sparkfun/SparkFun_Qwiic_BMA456_Accelerometer/docs/docs/Resources.md

For more information about the SparkFun Triple Axis Accelerometer Breakout - BMA456 (Qwiic) take a look at the following resources:

* [Schematic](/ref/Qwiic_BMA456.pdf)
* [KiCad Files](/ref/Qwiic_BMA456.zip)
* [Board Dimensions]()
* [Datasheet](/ref/bma456.pdf) (BMA456)
* [SparkFun BMA456 Arduino Library](https://github.com/sparkfun/SparkFun_BMA456_Arduino_Library)
* [GitHub Repository](https://github.com/sparkfun/SparkFun_Qwiic_BMA456_Accelerometer)
