sparkfun/SparkFun_Qwiic_BMA456_Accelerometer/Hardware/Qwiic_BMA456.kicad_pcb

## KiCad design Hardware/Qwiic_BMA456.kicad_pcb (2026-09-10)

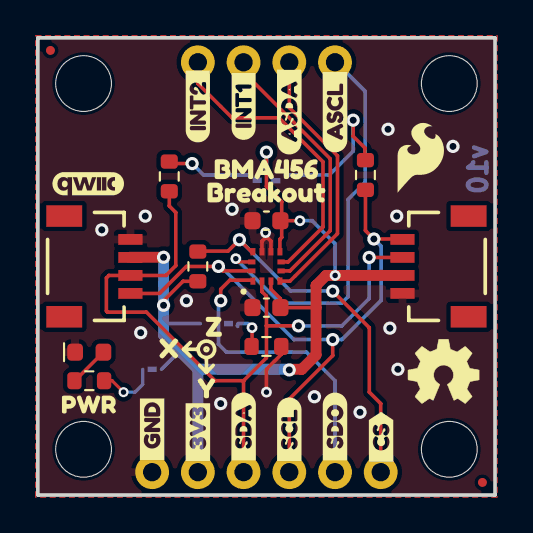
[picture p4: board Qwiic_BMA456.kicad_pcb from above]

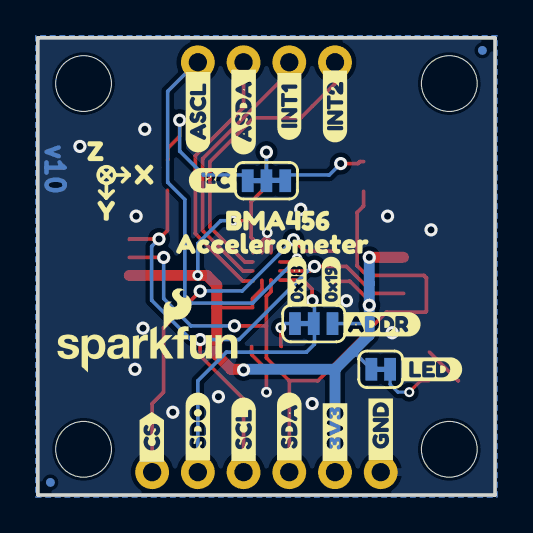
[picture p5: board Qwiic_BMA456.kicad_pcb from below]

Board: 2 copper layers, 25.4 x 25.4 mm, 61 parts (25 on the bottom side), 15 nets.

Parts:
C1, C4: 0.1uF; C_0603_1608Metric
D1: Red; LED_0603_1608Metric_Red
FID1, FID2, FID3, FID4: Fiducial_0.5mm; Fiducial_0.5mm_Mask1mm
J0: LED; Jumper_2_NC_Trace
J1: Conn_01x04; 1x04_P2.54mm
J2, J4: Qwiic_RA; JST_1x04_P1.0mm_Horizontal_SMD
J3: I²C; Jumper_3_NC-2_Trace
J5: Conn_01x06; 1x06_P2.54mm
J6: ADDR; Jumper_3_NC-1_Trace
R1, R2, R3, R4, R7: 4.7k; R_0603_1608Metric
Ref**: Val**; OSHW_Logo_4mm
ST3, ST4, ST7, ST8: Standoff
U1: BMA456; LGA-12_2x2mm
kibuzzard-6A8DBB71: G***; kibuzzard-6A8DBB71
kibuzzard-6A8DBB79: G***; kibuzzard-6A8DBB79
kibuzzard-6A8DBBAF, kibuzzard-6A8DBBAF#2: G***; kibuzzard-6A8DBBAF
kibuzzard-6A8DBBBE, kibuzzard-6A8DBBBE#2: G***; kibuzzard-6A8DBBBE
kibuzzard-6A8DBBCD, kibuzzard-6A8DBBCD#2: G***; kibuzzard-6A8DBBCD
kibuzzard-6A8DBBD9, kibuzzard-6A8DBBD9#2: G***; kibuzzard-6A8DBBD9
kibuzzard-6A8DC94F: G***; kibuzzard-6A8DC94F
kibuzzard-6A8DC959: G***; kibuzzard-6A8DC959
kibuzzard-6A84B2F6: G***; kibuzzard-6A84B2F6
kibuzzard-6A84B31F: G***; kibuzzard-6A84B31F
kibuzzard-6A848A2E, kibuzzard-6A848A2E#2: G***; kibuzzard-6A848A2E
kibuzzard-6A848A36, kibuzzard-6A848A36#2: G***; kibuzzard-6A848A36
kibuzzard-6A848AC1: G***; kibuzzard-6A848AC1
kibuzzard-6A848B8C: G***; kibuzzard-6A848B8C
kibuzzard-6A848CE4: G***; kibuzzard-6A848CE4
kibuzzard-6A848CEC: G***; kibuzzard-6A848CEC
kibuzzard-6A848D2C: G***; kibuzzard-6A848D2C
kibuzzard-6A848D3D: G***; kibuzzard-6A848D3D
kibuzzard-6A8489CE, kibuzzard-6A8489CE#2: G***; kibuzzard-6A8489CE
kibuzzard-689A642E: G***; kibuzzard-689A642E
kibuzzard-689A6711, kibuzzard-689A6711#2: G***; kibuzzard-689A6711
kibuzzard-689A6718, kibuzzard-689A6718#2: G***; kibuzzard-689A6718
kibuzzard-689A6721, kibuzzard-689A6721#2: G***; kibuzzard-689A6721
kibuzzard-689A6728, kibuzzard-689A6728#2: G***; kibuzzard-689A6728
kibuzzard-689A6796: G***; kibuzzard-689A6796

Connections:
3.3V: C1.1, C4.1, J0.2 (B), J2.2, J3.2 (B), J4.2, J5.2, J6.3 (C), R2.2, U1.3 (VDDIO), U1.7 (VDD)
ASCL: J1.1, U1.11 (ASCL)
ASDA: J1.2, U1.4 (ASDA)
GND: C1.2, C4.2, D1.1 (K), J2.1, J4.1, J5.1, R4.1, U1.8 (GND), U1.9 (GND)
INT1: J1.3, U1.5 (INT1)
INT2: J1.4, U1.6 (INT2)
unnamed: D1.2 (A), R3.1
unnamed: J0.1 (A), R3.2
unnamed: J3.1 (A), R7.2
unnamed: J3.3 (C), R1.2
unnamed: J6.1 (A), R4.2
SCX: J2.4, J4.4, J5.4, R7.1, U1.12 (SCX)
SDO: J5.5, J6.2 (B), U1.1 (SDO)
SDX: J2.3, J4.3, J5.3, R1.1, U1.2 (SDX)
~CS: J5.6, R2.1, U1.10 (~CS)
