sparkfun/SparkFun_Qwiic_BMA456_Accelerometer/docs/docs/software/arduino setup.md

# Arduino Setup

This example assumes you are using the latest version of the Arduino IDE on your desktop. If this is your first time using Arduino IDE, library, or board add-on, please review the following tutorials.

- [Installing the Arduino IDE](https://learn.sparkfun.com/tutorials/installing-arduino-ide)
- [Installing an Arduino Library](https://learn.sparkfun.com/tutorials/installing-an-arduino-library)
- [Installing Board Definitions in the Arduino IDE](https://learn.sparkfun.com/tutorials/installing-board-definitions-in-the-arduino-ide)

## Installing the SparkFun BMA456 Arduino Library

This library is built using the [SparkFun Toolkit](https://github.com/sparkfun/SparkFun_Toolkit) so you'll need to make sure that is installed before using this library. Install the SparkFun Toolkit with the Arduino Library manager by searching "SparkFun Toolkit" and installing the latest version. Users who prefer manually installing Arduino Libraries can download it from the [GitHub Repository](https://github.com/sparkfun/SparkFun_Toolkit).

The SparkFun BMA456 Arduino Library includes twelve examples that demonstrate how to get data from the sensor and cover all the main features of the BMA456. Install the library using the Arduino Library Manager tool by searching for "SparkFun BMA456" and install the latest version. If you'd prefer to manually install the library, you can download it from the [GitHub Repository](https://github.com/sparkfun/SparkFun_BMA456_Arduino_Library) or you can download a ZIP of the repository [here](https://github.com/sparkfun/SparkFun_BMA456_Arduino_Library/archive/refs/heads/main.zip).
