sparkfun/SparkFun_Qwiic_BMA456_Accelerometer/docs/docs/support/file_issue.md

# Submit Issues

## Support

If you need technical assistance and more information on a product that is not working as you expected, visit the [SparkFun Community](https://community.sparkfun.com). The community forums are monitored by the SparkFun Technical Support Team and the SparkFun community as a whole.

## Existing Issue

Spot something wrong? Please check the list of reported and fixed issues  .  in this repository.

## Discrepancies in the Documentation

All of this documentation can be modified by you! Please help us make it better.

* The documentation files for these pages are contained in the [`docs` folder of the SparkFun Triple Axis Accelerometer Breakout - BMA456 (Qwiic) repository](https://github.com/sparkfun/SparkFun_Qwiic_BMA456_Accelerometer/tree/main/docs).

### Spot something wrong?

If a section of the documentation is incorrect, please [open an issue](https://github.com/sparkfun/SparkFun_Qwiic_BMA456_Accelerometer/issues) and let us know.

### Do you have a suggested correction?

1. With a GitHub account, fork this repo
2. Add your correction(s) or improvement(s) to the markdown file(s)
3. File a pull request with your changes, and enjoy making the ~~words~~ ~~worlds~~ world a better place.
    * Once received, the documentation specialist will automatically be notified.
    * We will review your suggested improvement(s) to make sure they are correct and fit within our documentation standards.

## Problems in the Hardware Design

All of our designs are open-source! Please help us make it better.

* Our board design files are contained in the [`Hardware` folder of the SparkFun Triple Axis Accelerometer Breakout - BMA456 (Qwiic) repository](https://github.com/sparkfun/SparkFun_Qwiic_BMA456_Accelerometer/tree/main/Hardware).

### Does something not make sense?

If part of the design is confusing, please [open an issue](https://github.com/sparkfun/SparkFun_Qwiic_BMA456_Accelerometer/issues) and let us know.

### Did we forget to include an important function of the board?

Please keep in mind that we may intentionally exclude certain functions of the board to meet our product design requirements.

If part of the board's functionality is missing, please [open an issue](https://github.com/sparkfun/SparkFun_Qwiic_BMA456_Accelerometer/issues) and file a feature request.

### Do you wish to contribute directly to improving the board design?

1. With a GitHub account, Fork this repo
2. Add your design improvement(s)
3. File a pull request with your changes, and enjoy making the ~~words~~ ~~worlds~~ world a better place.
    * Once received, the engineer in charge of the original design will automatically be notified.
    * We will review your suggested improvement(s), if they are within our board design standards and meet our product design requirements, we will flag these changes for our next board revision. *(Please note, that even if your suggestion is accepted, these changes may not be immediate. We may have to cycle through our current product inventory first.)*
