sparkfun/SparkFun_Qwiic_BMA456_Accelerometer/(notices)

Notices in the files:
Hardware/Qwiic_BMA456.kicad_pcb:
Released under the Creative Commons Attribution Share-Alike 4.0 License
https://creativecommons.org/licenses/by-sa/4.0
